kisgoody/CirrusLogic/(list of files, cad)

Other CAD files:
CRD42L42-MFi/MCU Firmware/STM8L10x_bootloader/stm8l10x_bootloader.stp
CRD42L42-MFi/MCU Firmware/STM8L10x_bootloader/stm8l10x_bootloader_Programmer/stm8l10x_bootloader_STVP.stp
CRD42L42-MFi/MCU Firmware/STM8L10x_fw/STVD/Cosmic/stm8l10x.stp
CRD42L42-MFi/MCU Firmware/STM8L10x_fw/STVD/Cosmic/stm8l10x_Programmer/stm8l10x_STVP.stp
CRD42L42-MFi/MCU Firmware/stm8l10x_FW_Programming.stp
CRD42L42-MFi/MCU Firmware/STM8L10x_LAM_init/STVD/Cosmic/stm8l10x.stp
CRD42L42-MFi/MCU Firmware/STM8L10x_LAM_init/STVD/Cosmic/stm8l10x_Programmer/stm8l10x_STVP.stp
CRD42L42-MFi/MCU Firmware/STM8L10x_LAM_init_test/STVD/Cosmic/stm8l10x_LAM_init_test.stp
CRD42L42-MFi/MCU Firmware/STM8L10x_LAM_init_test/STVD/Cosmic/stm8l10x_LAM_init_test_Programmer/stm8l10x_LAM_init_test_STVP.stp
CRD42L42-MFi/MCU Firmware/STM8L10x_LAM_init_test/STVD/Cosmic/stm8l10x_Programmer/stm8l10x_STVP.stp
CRD42L42-MFi/MCU Firmware/STM8L10x_fw/STVD/Cosmic/stm8l10x_fw.stp
CRD42L42-MFi/MCU Firmware/STM8L10x_LAM_init/STVD/Cosmic/stm8l10x_LAM_init.stp
CRD42L42-MFi/MCU Firmware/stm8l10x_LAM_init_Programming.stp
CRD42L42-MFi/MCU Firmware/STM8L10x_LAM_init_test/STVD/Cosmic/stm8l10x.stp
