kisgoody/CirrusLogic/CRD42L42-MFi/PCB/CDB42L42-MFi_Rev_B_sch.pdf

REV | DESCRIPTION | DATE

### ECN

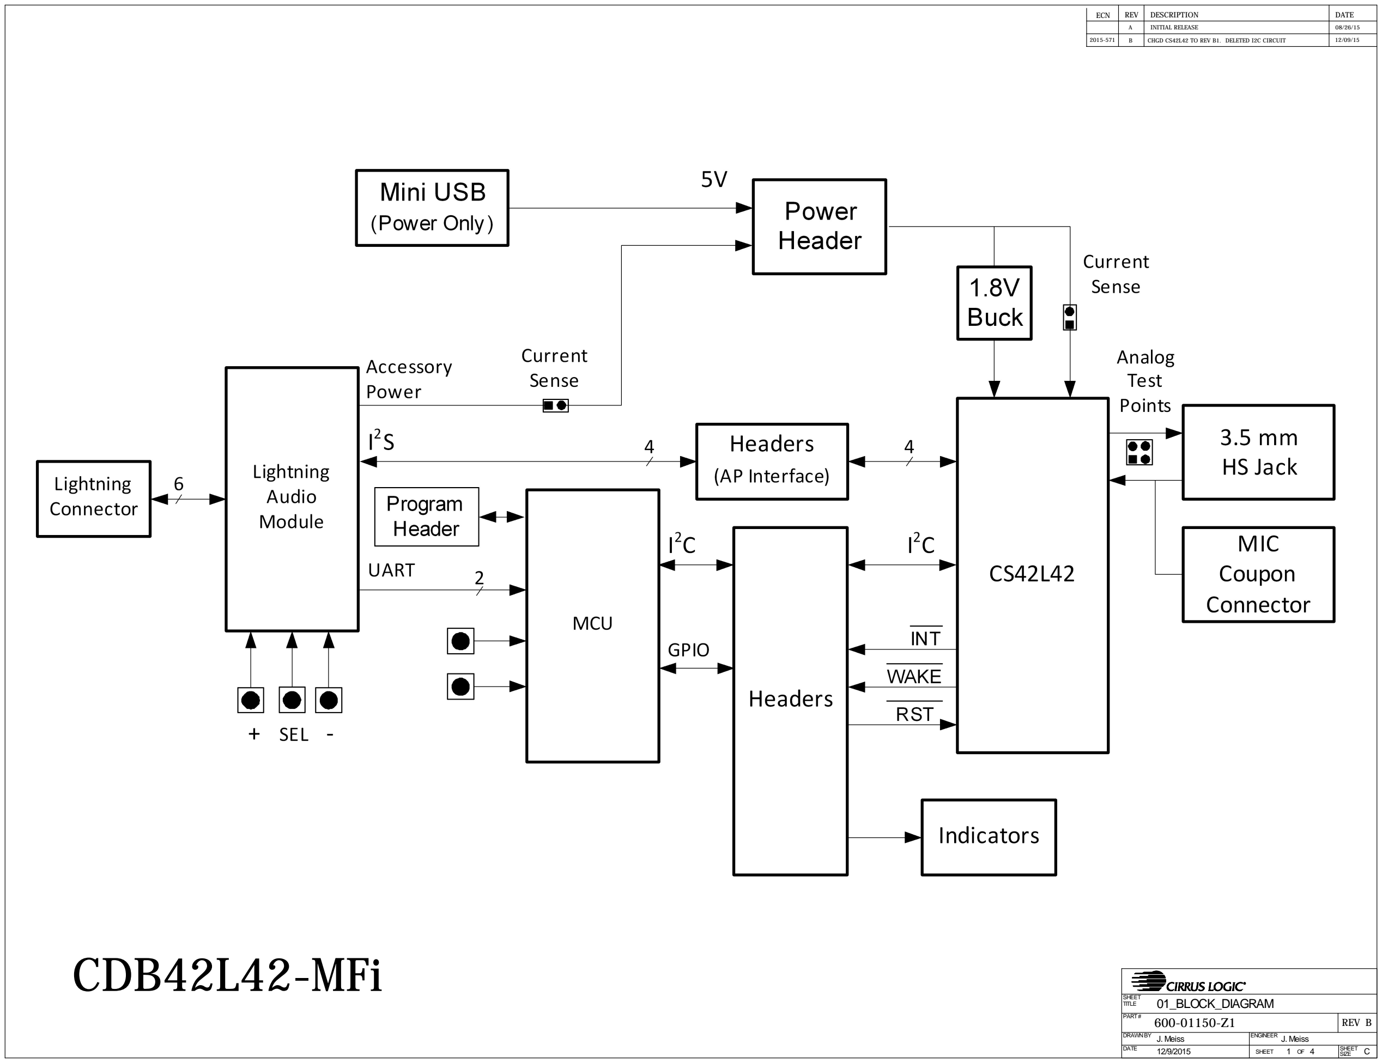
[picture p1: page 1]

TITLE

# 01_BLOCK_DIAGRAM

SHEET

PART # 600-01150-Z1 | REV B
DRAWN BY J. Meiss | ENGINEER J. Meiss
DATE | SHEET OF | SIZE C
A | INITIAL RELEASE | 08/26/15

# CDB42L42-MFi

2015-571 | B | CHGD CS42L42 TO REV B1. DELETED I2C CIRCUIT | 12/09/15

# Connectors

# Lightning Interface

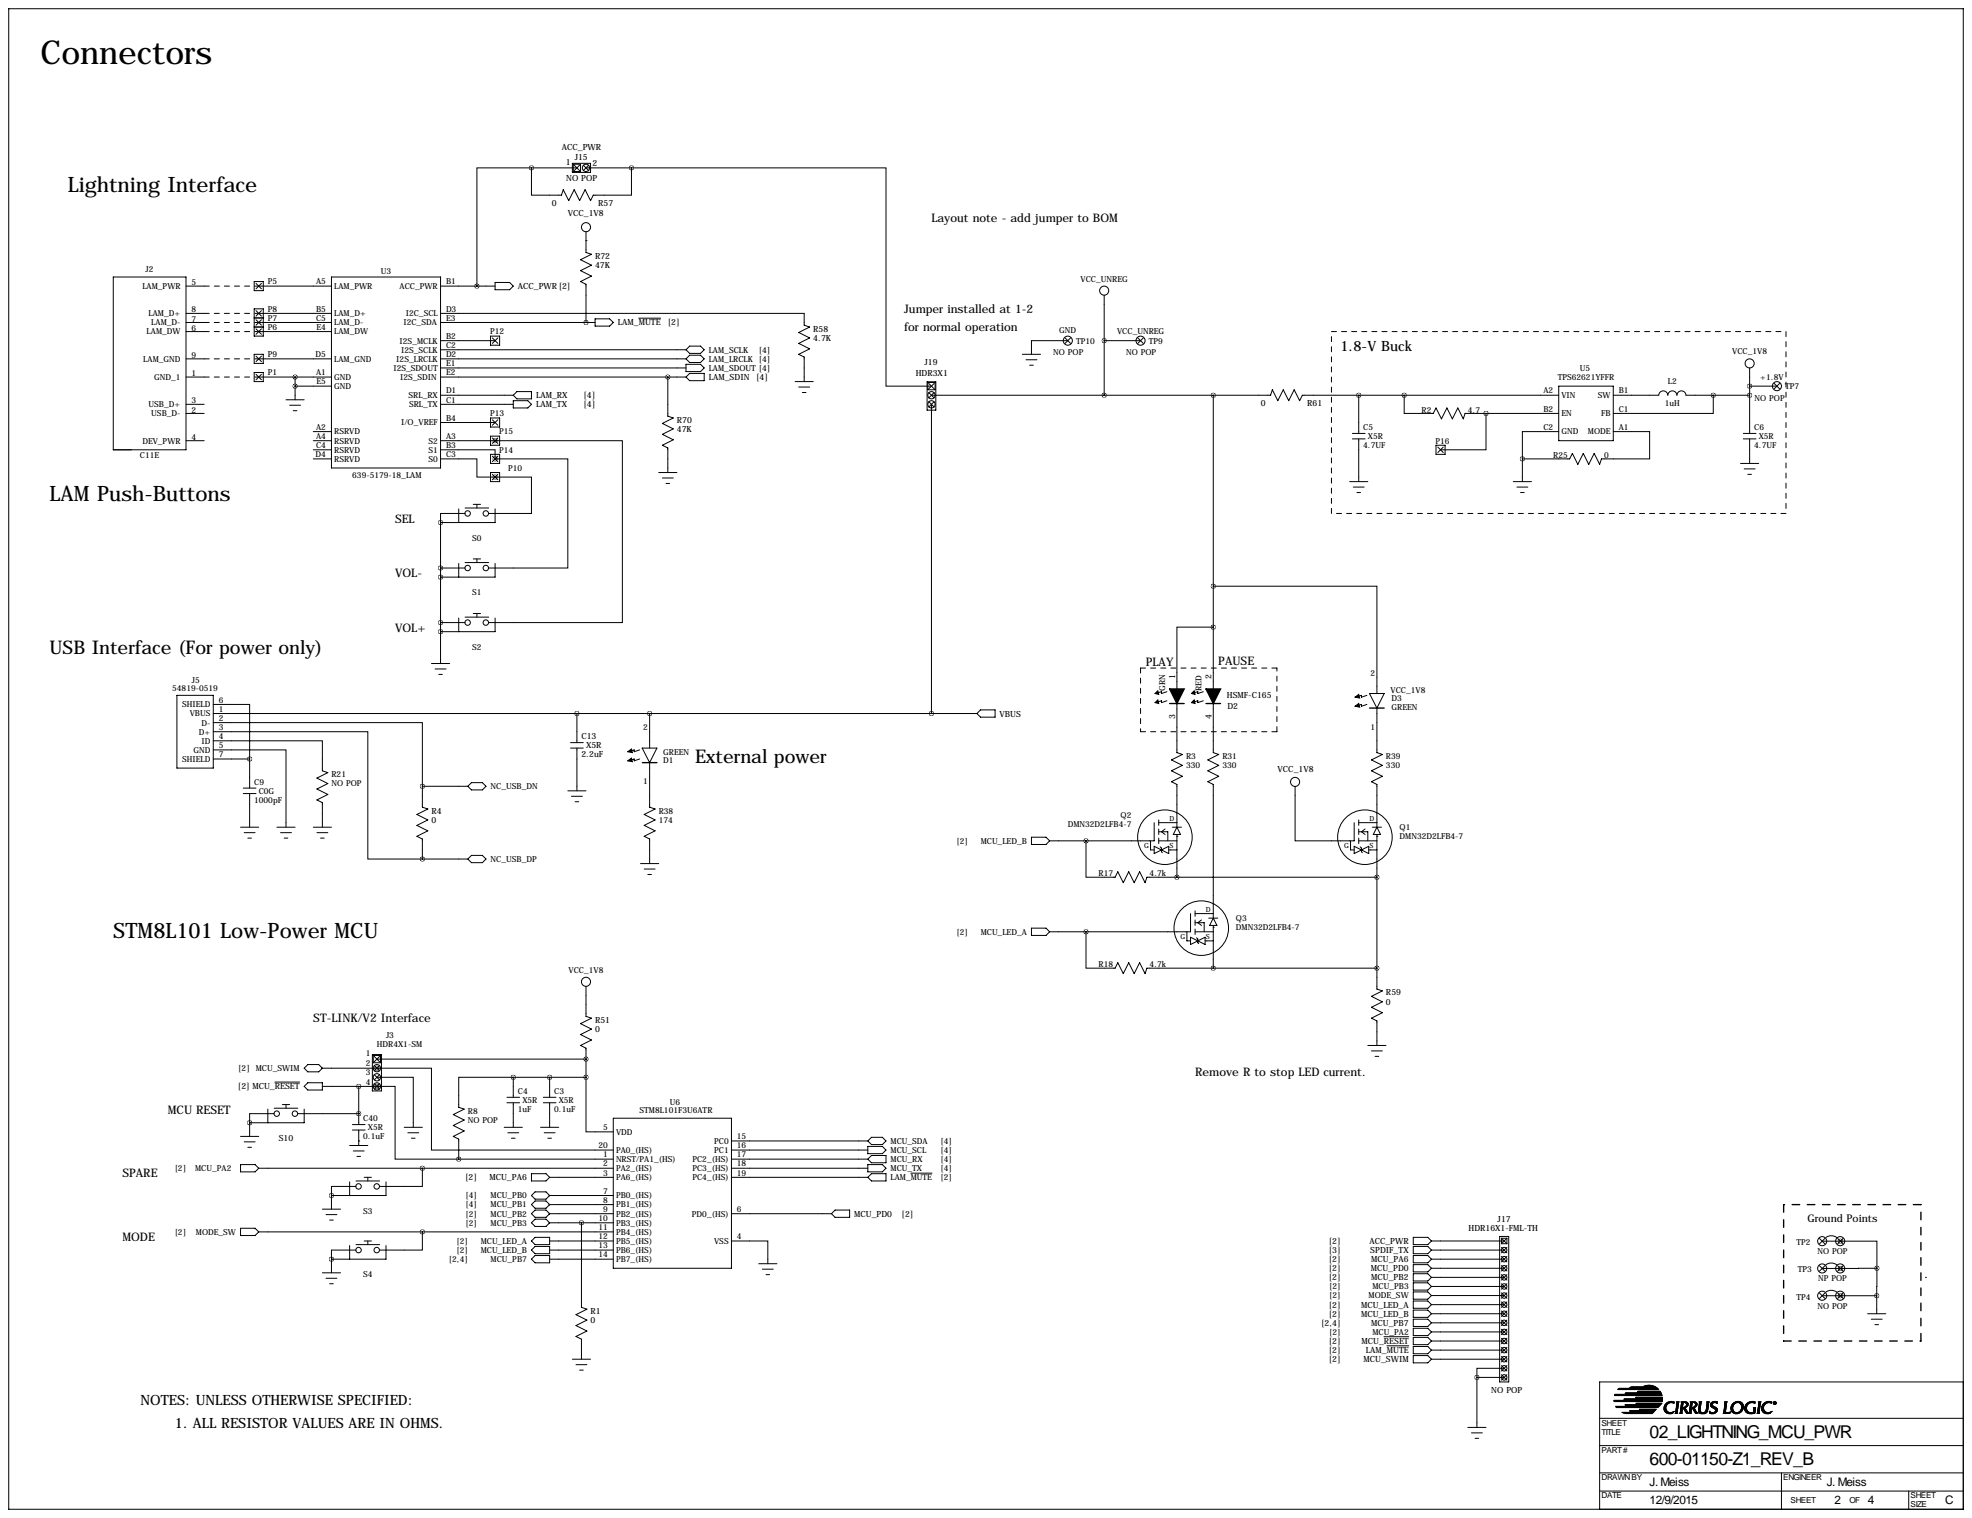
[picture p2: page 2]

Layout note - add jumper to BOM

1.8-V Buck | VCC_1V8

USB Interface (For power only)

Remove R to stop LED current.

NOTES: UNLESS OTHERWISE SPECIFIED:
1. ALL RESISTOR VALUES ARE IN OHMS.

# CS42L42 Codec

# I2C Signals

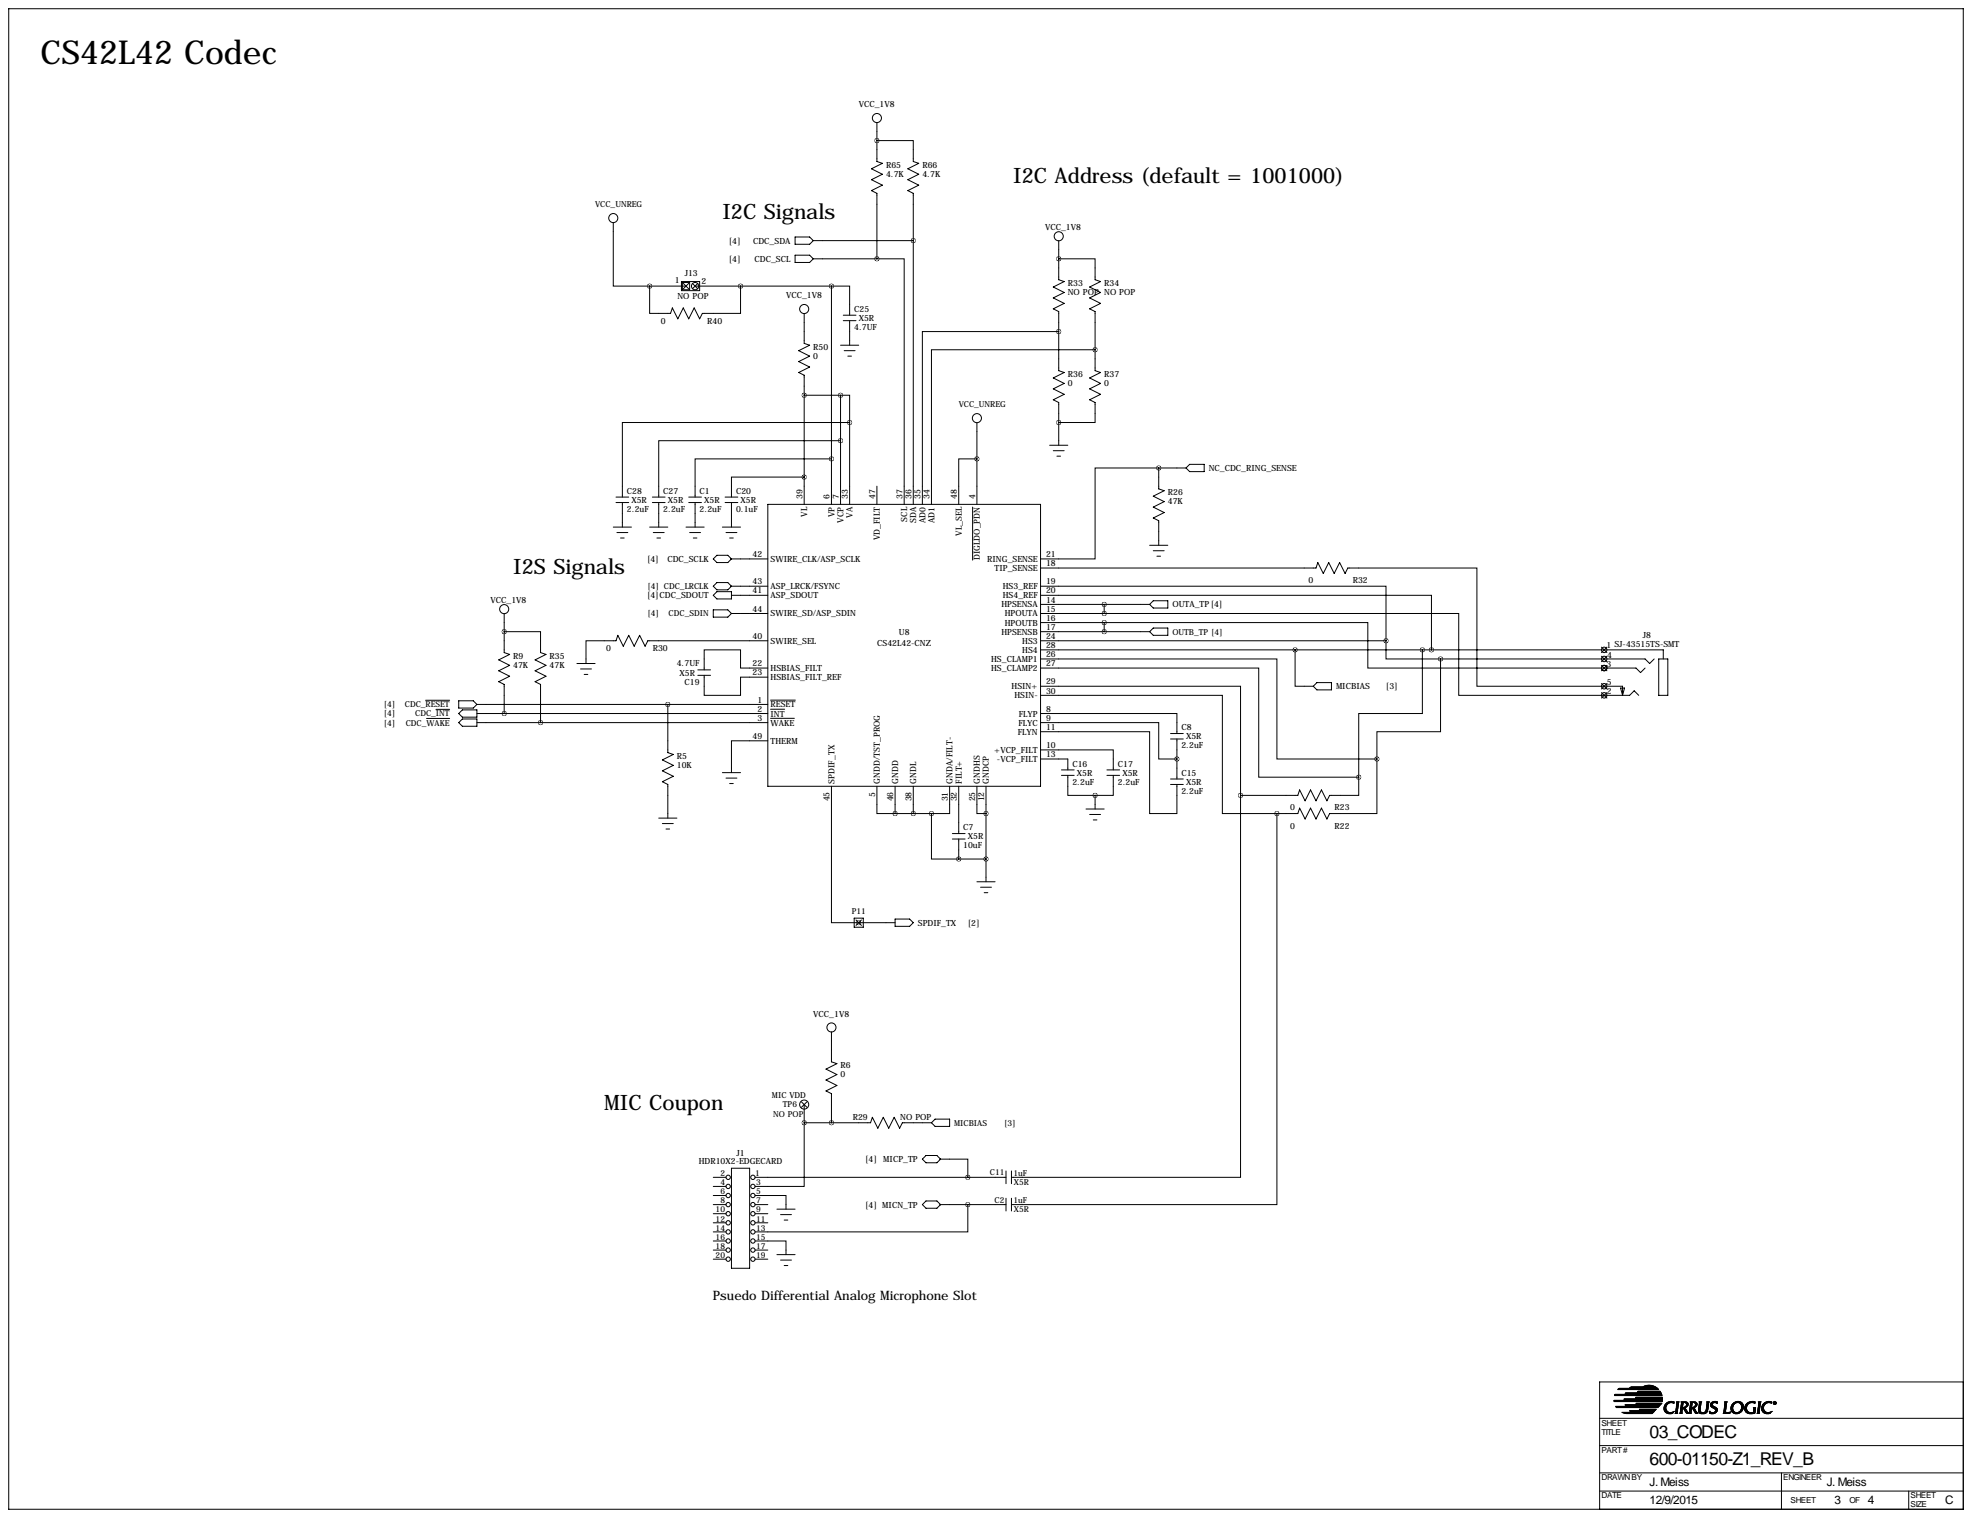
[picture p3: page 3]

17 HPSENSB

28 HS4 26 HS_CLAMP1

Psuedo Differential Analog Microphone Slot

# Audio Serial Port Headers, Communication Ports

# Audio Serial Port Header for AP

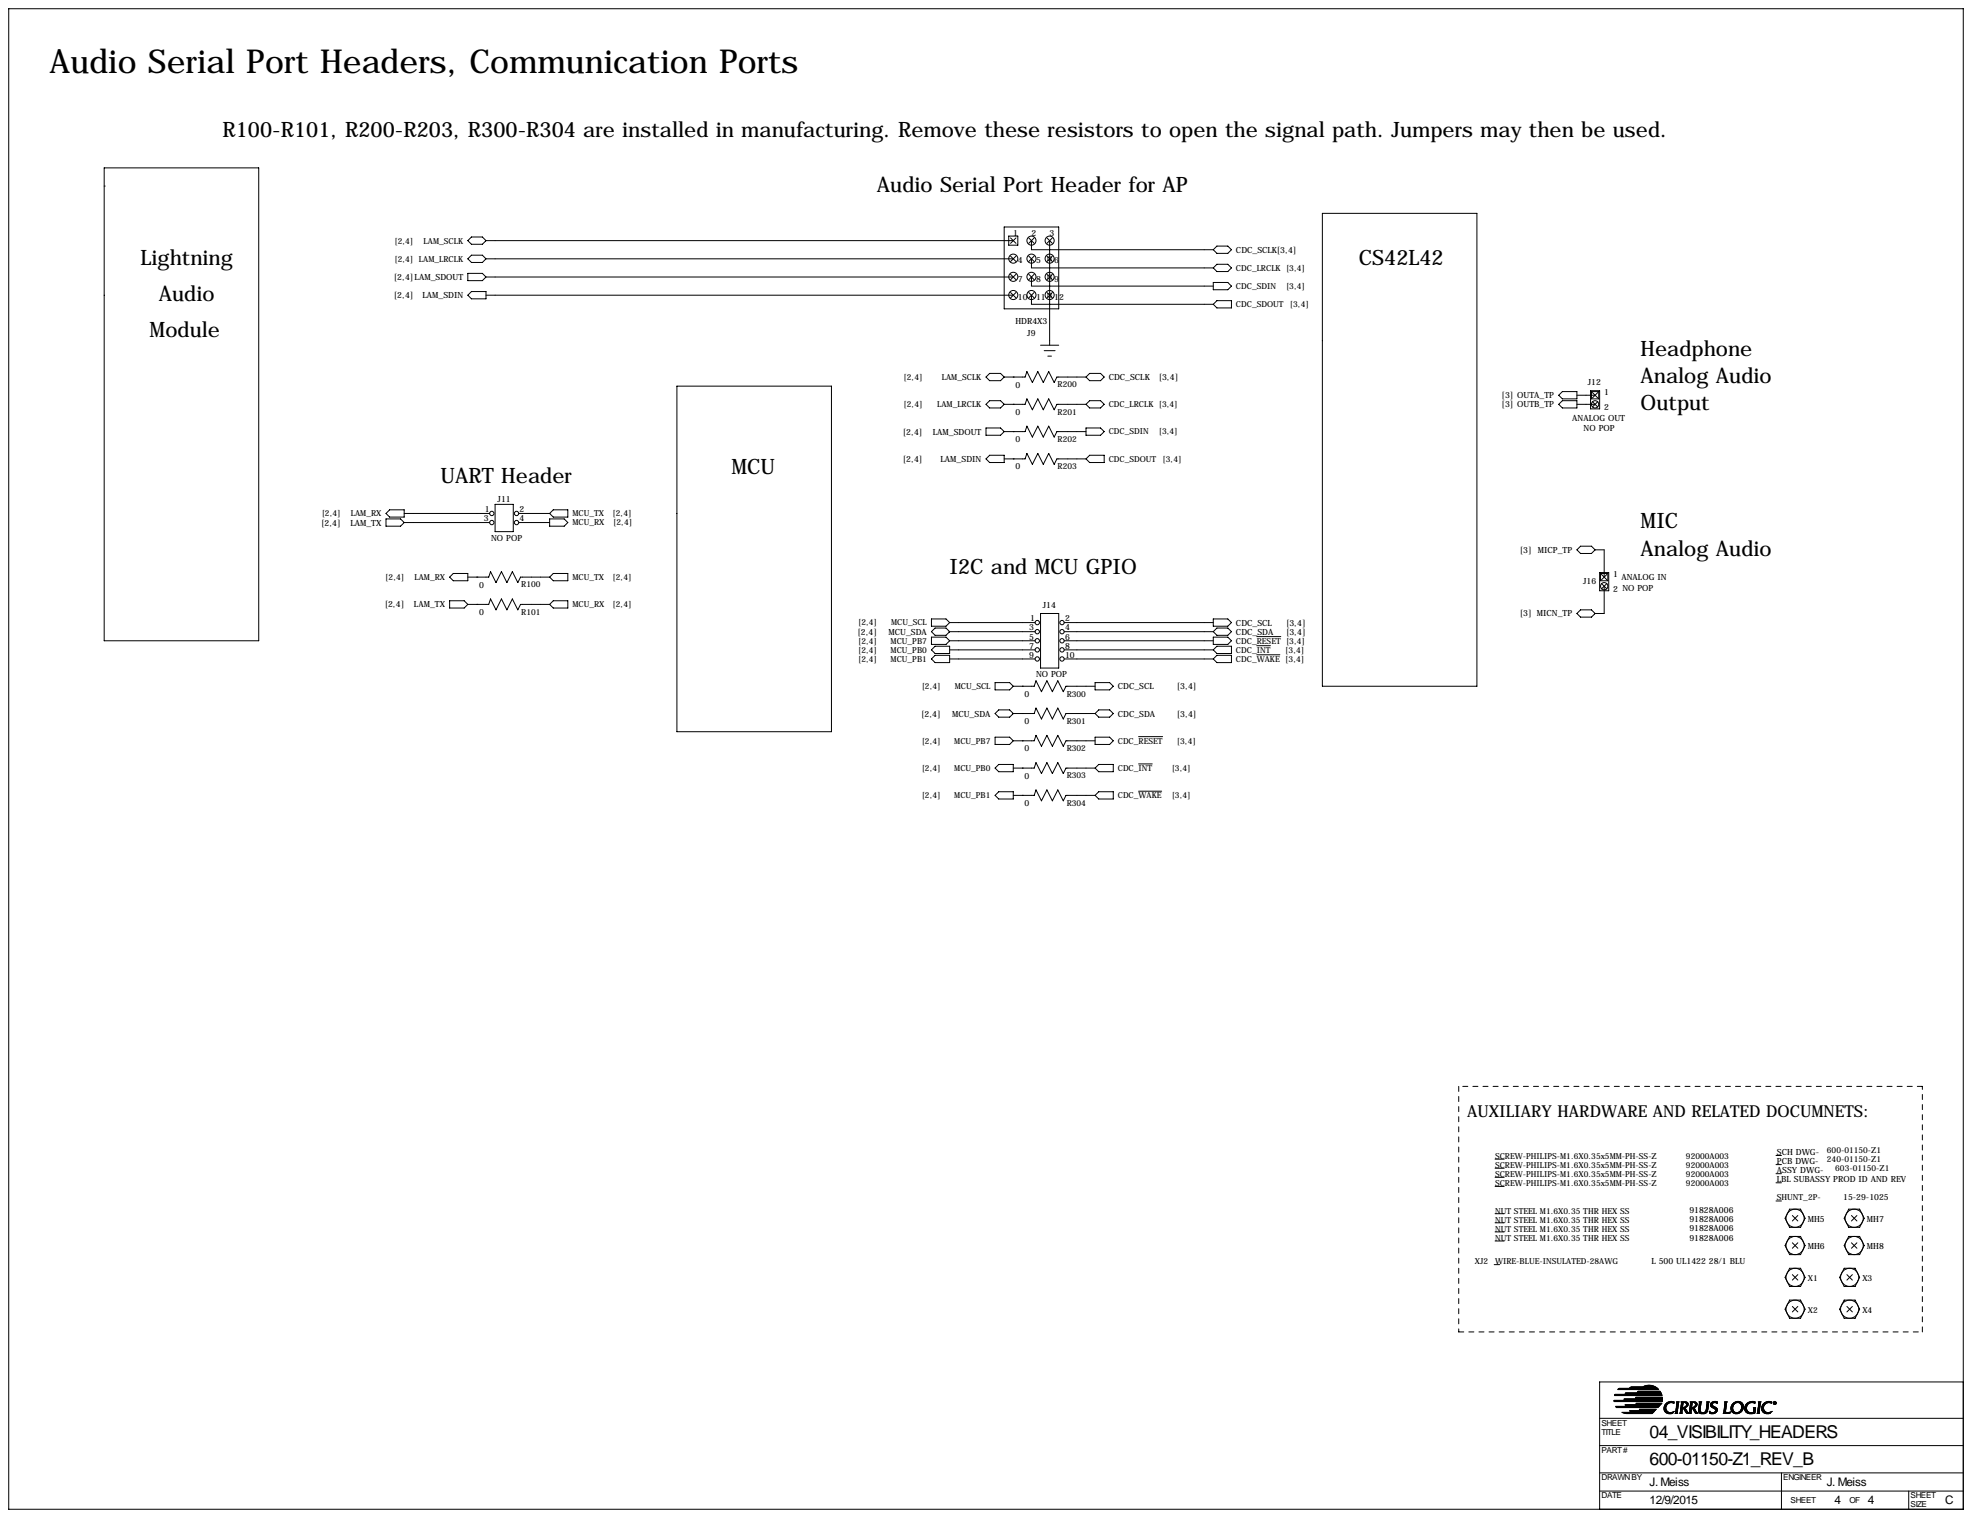
[picture p4: page 4]

R100-R101, R200-R203, R300-R304 are installed in manufacturing. Remove these resistors to open the signal path. Jumpers may then be used.

AUXILIARY HARDWARE AND RELATED DOCUMNETS:

SCH DWG- 600-01150-Z1
PCB DWG- 240-01150-Z1
LBL SUBASSY PROD ID AND REV
