kisgoody/CirrusLogic/CRD42L42-MFi/PCB/CRD42L42-MFi_Rev_A2_sch.pdf

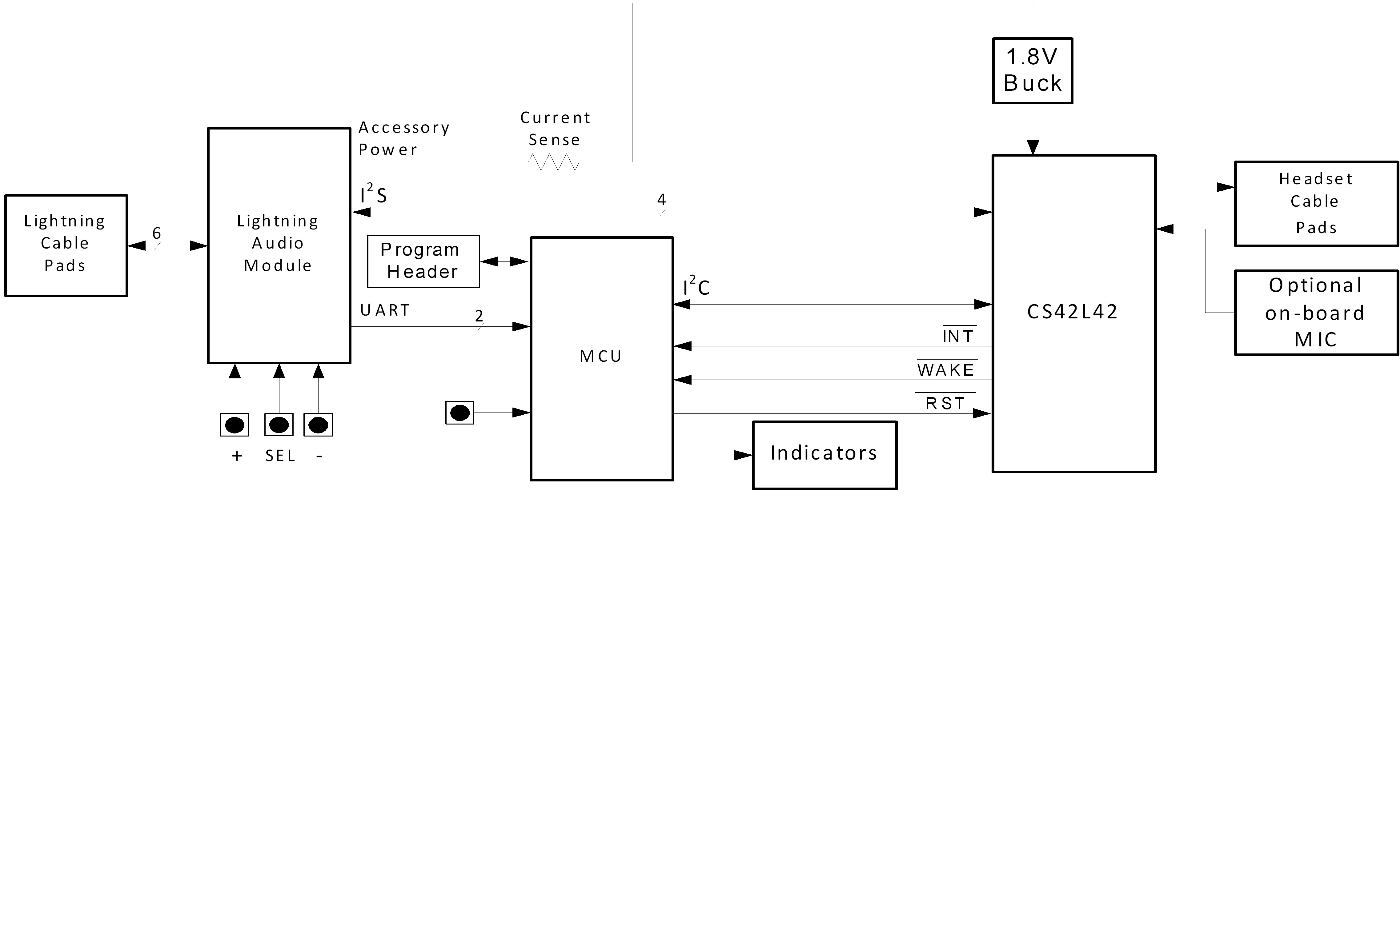
[picture p5: figure]

TITLE

# 01_BLOCK_DIAGRAM

SHEET

PART # 600-01160-Z1 | REV A1
DRAWN BY J. Meiss | ENGINEER J. Meiss
DATE | SHEET OF | SIZE C
REV | DESCRIPTION | DATE
A | INITIAL RELEASE | 09/22/15

# CRD42L42-MFi

### ECN

2015-662 | A1 | CHANGED D1 TO HSMF-C165, U8, CS42L42, TO REV B1 | 12/15/15
2016-871 | A2 | CHANGES

# Connectors

# Lightning Interface

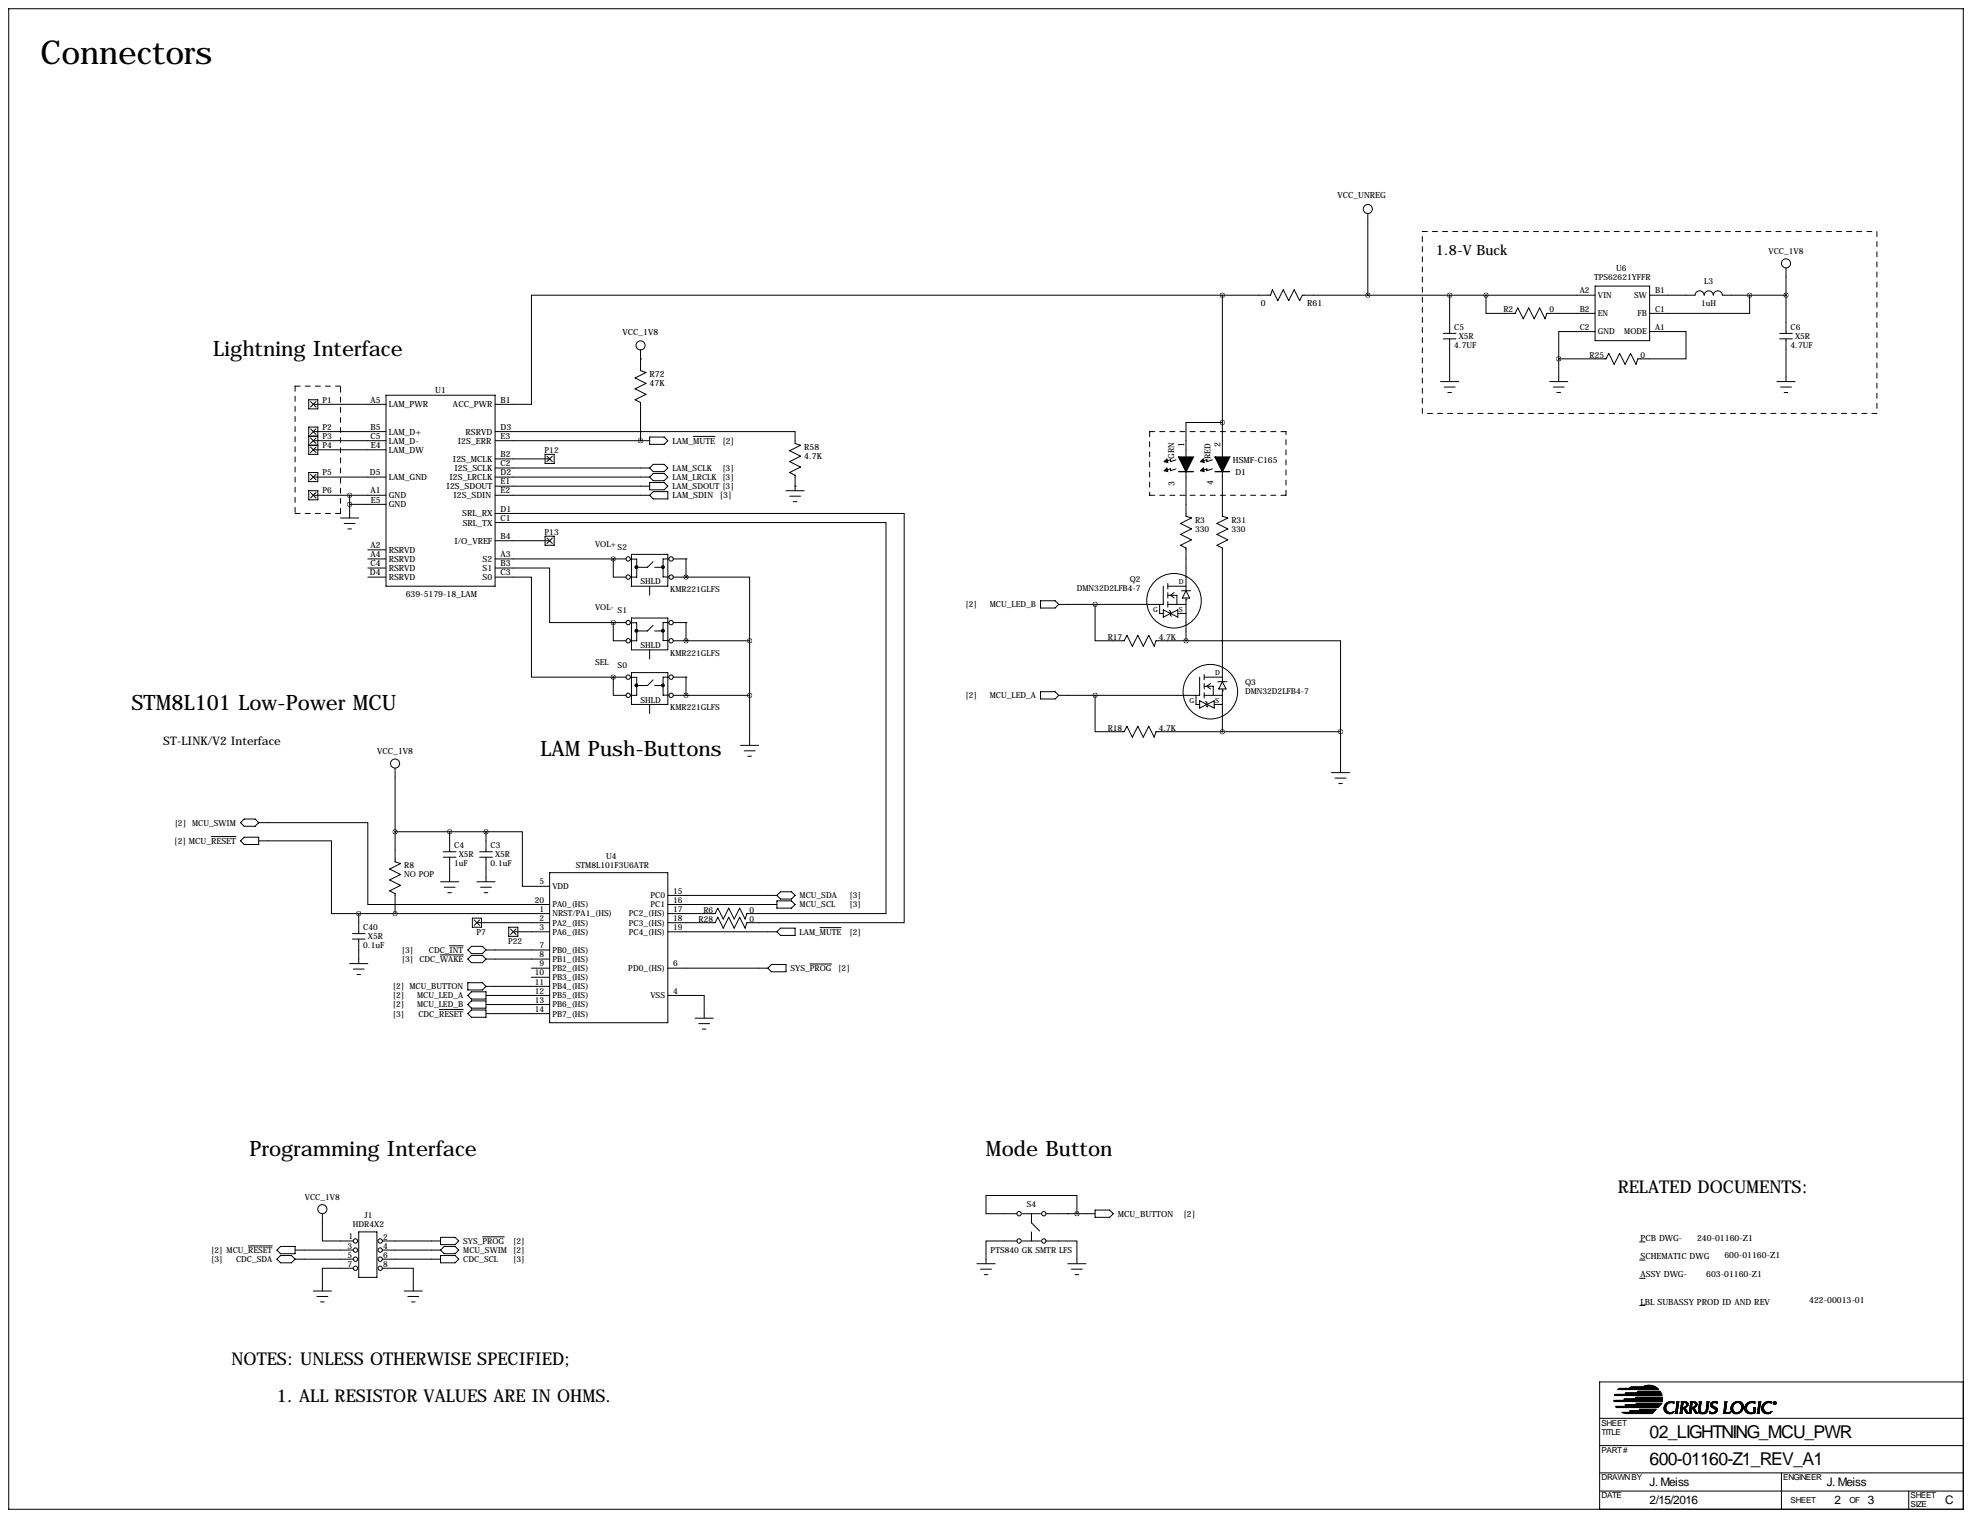
[picture p6: page 2]

NOTES: UNLESS OTHERWISE SPECIFIED;

1. ALL RESISTOR VALUES ARE IN OHMS.

# CS42L42 Codec

# I2C Signals

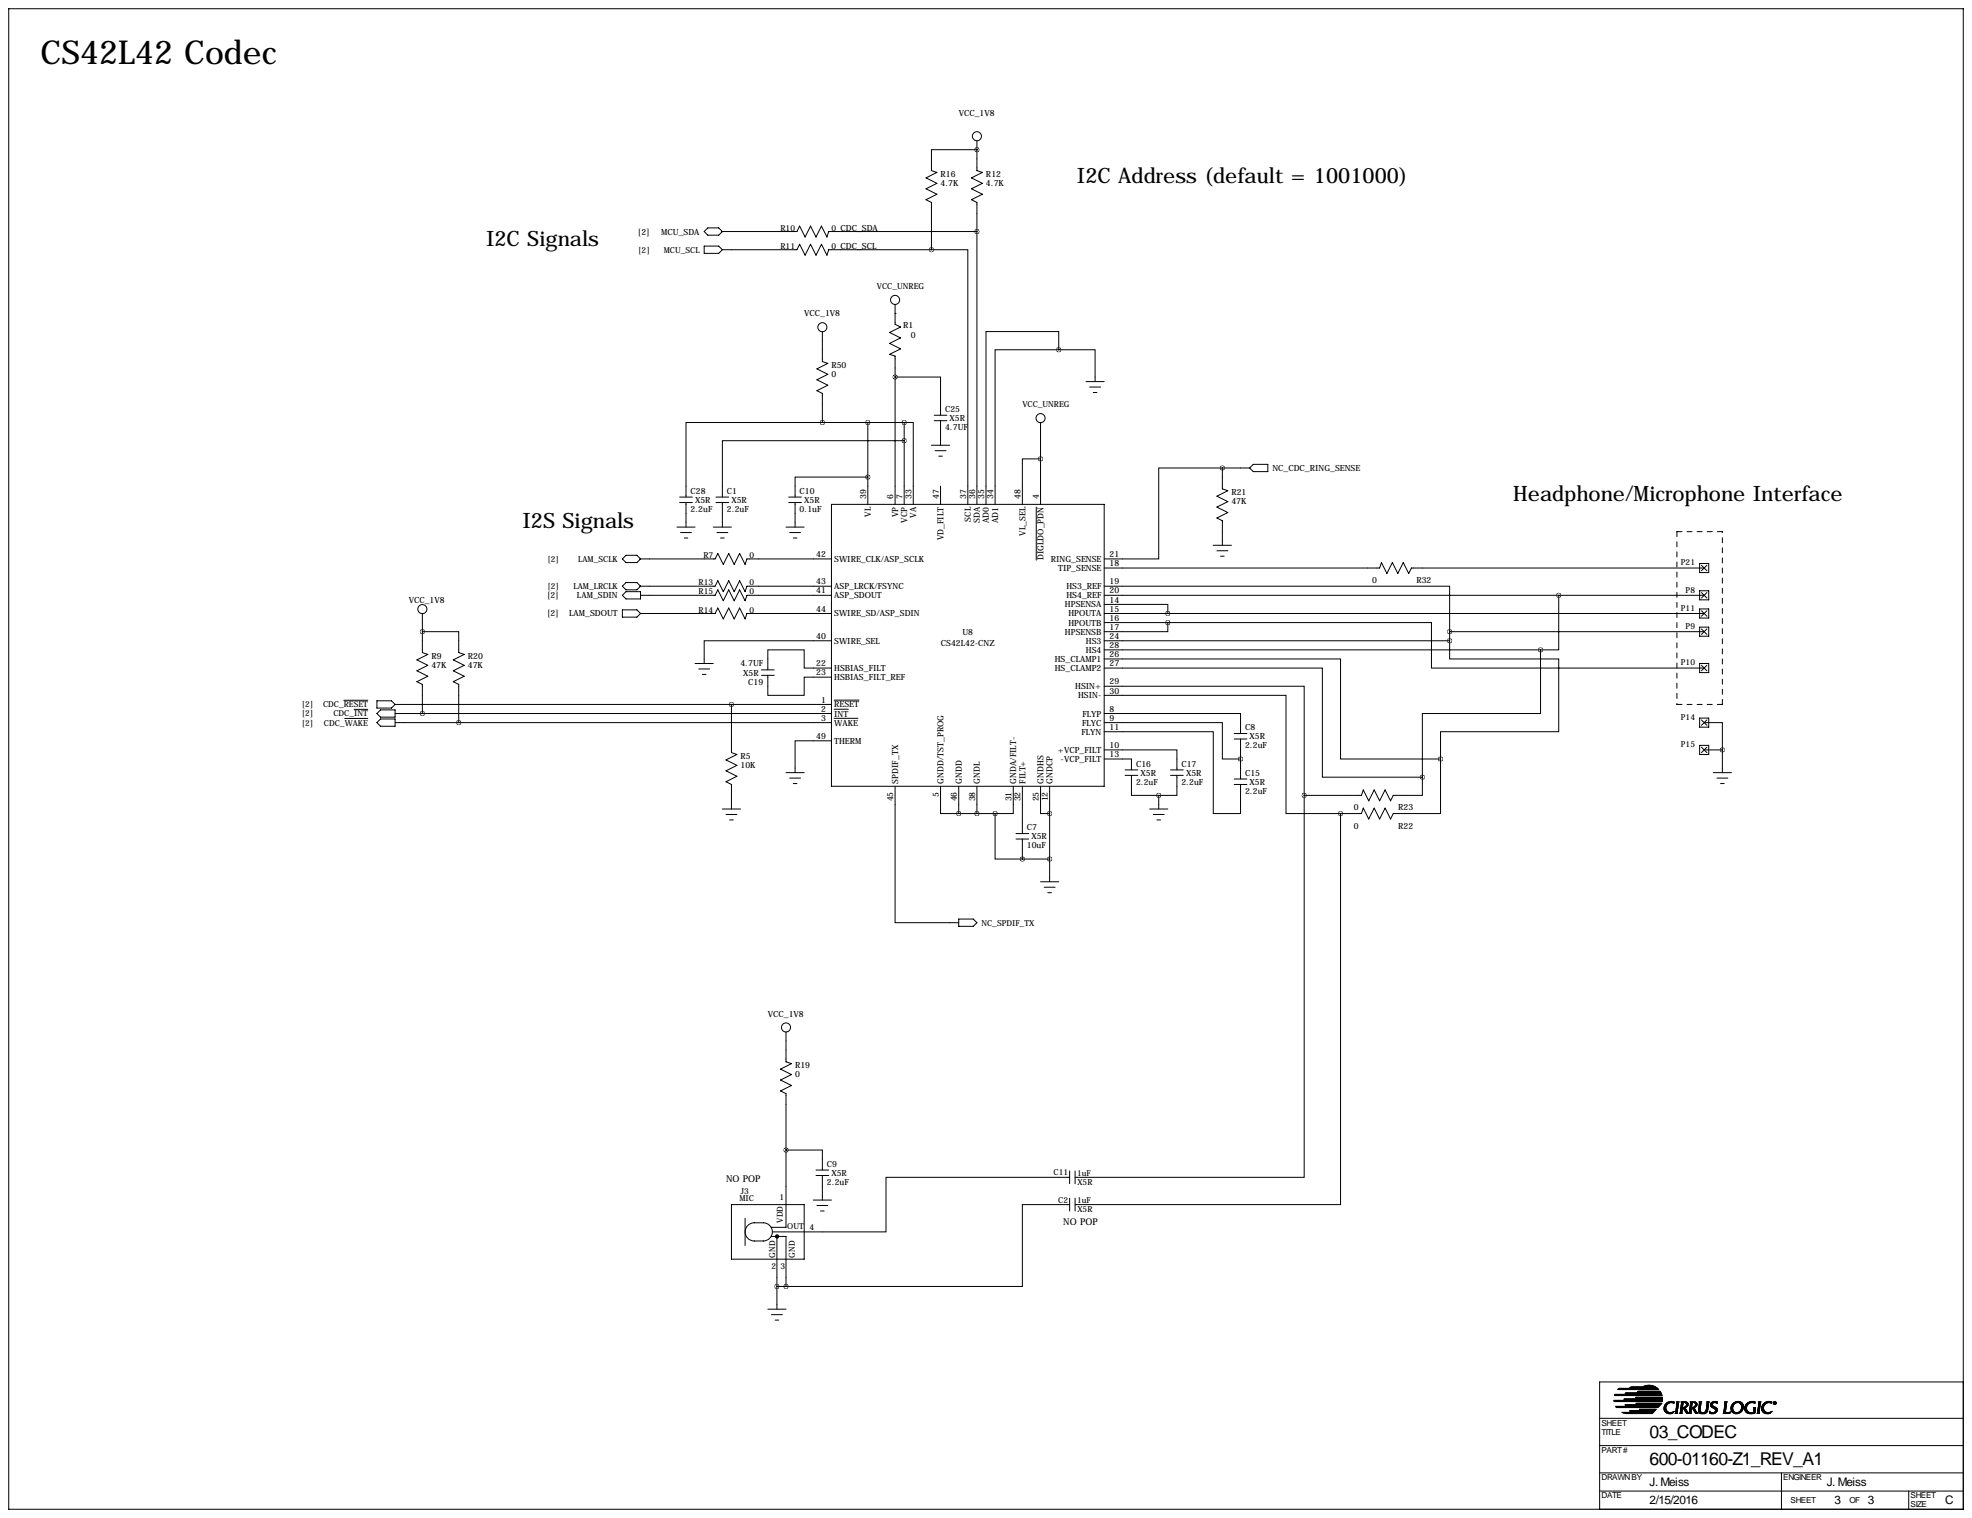
[picture p7: page 3]

17 HPSENSB

26 HS_CLAMP1
